SeeedDocument/Grove_Base_HAT/img/Grove Base HAT.JPG

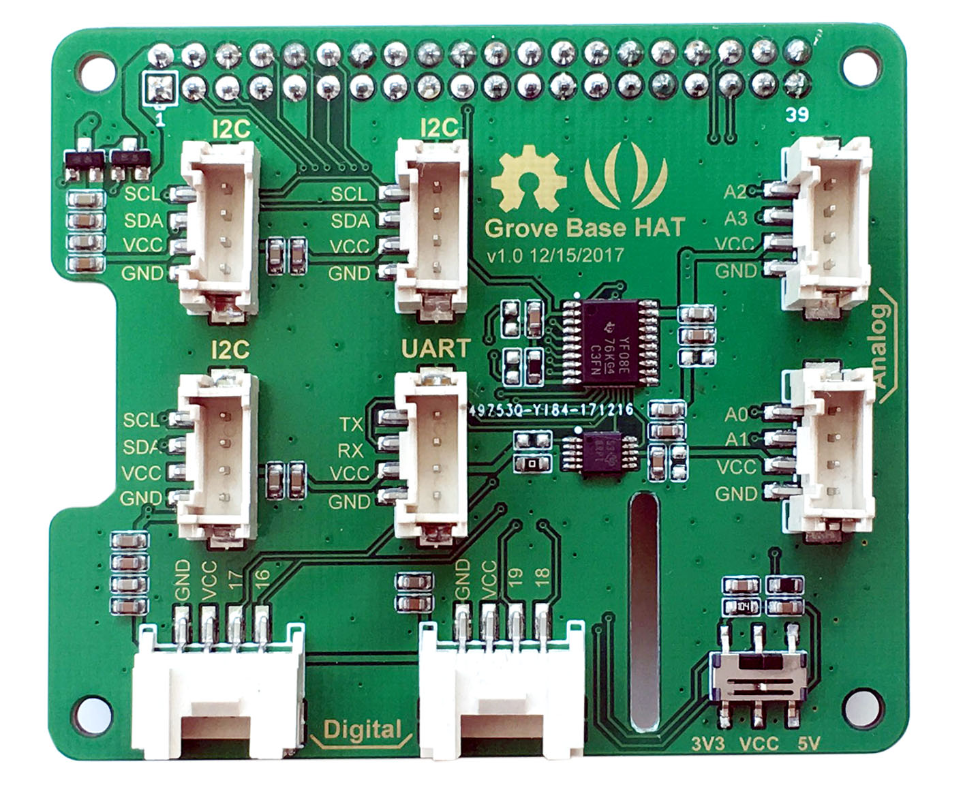
img/Grove Base HAT.JPG
