SeeedDocument/Grove_Base_HAT/img/enable_i2C.2.png

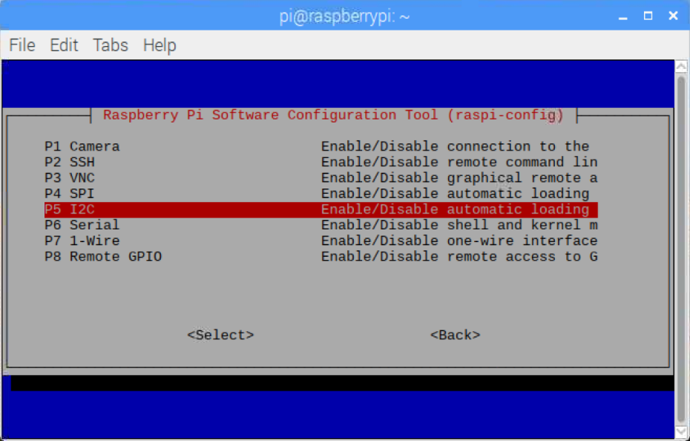
img/enable_i2C.2.png
