SeeedDocument/Grove_Base_HAT/img/enable_i2C.3.png

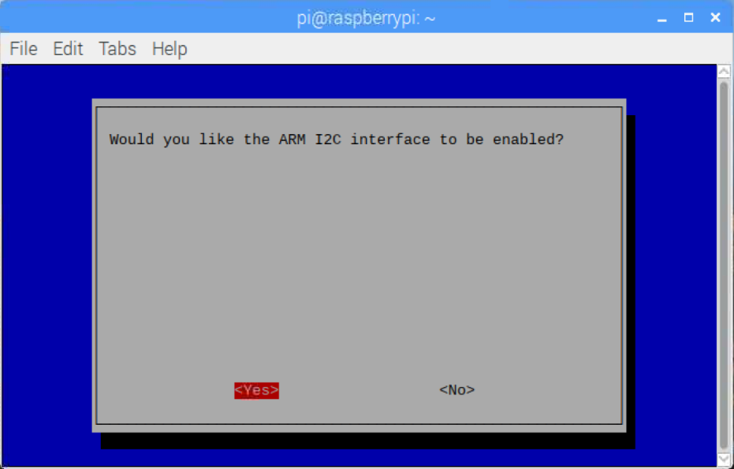
img/enable_i2C.3.png
