SeeedDocument/Grove_Base_HAT/img/Grove Base HAT_s.JPG

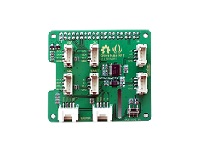
img/Grove Base HAT_s.JPG
