SeeedDocument/Grove_Base_HAT/res/Raspberry Pi Grove Base HAT BRD.pdf

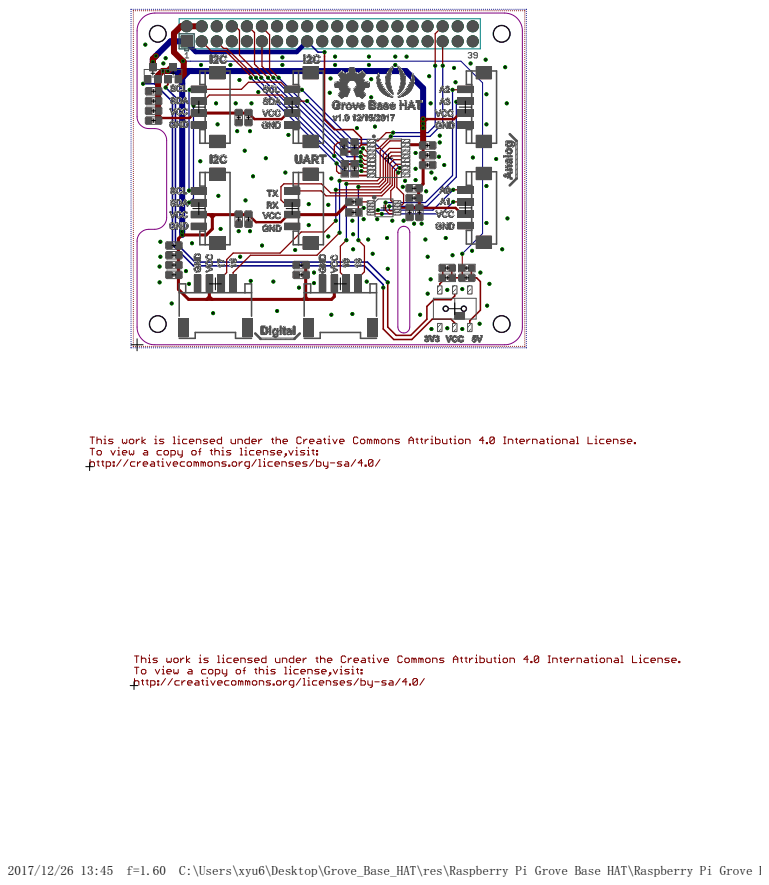
[picture p8: page 1]

2017/12/26 13:45 f=1.60 C:\Users\xyu6\Desktop\Grove_Base_HAT\res\Raspberry Pi Grove Base HAT\Raspberry Pi Grove Base HAT.brd
