SeeedDocument/Grove_Base_HAT/res/Raspberry Pi Grove Base HAT SCH.pdf

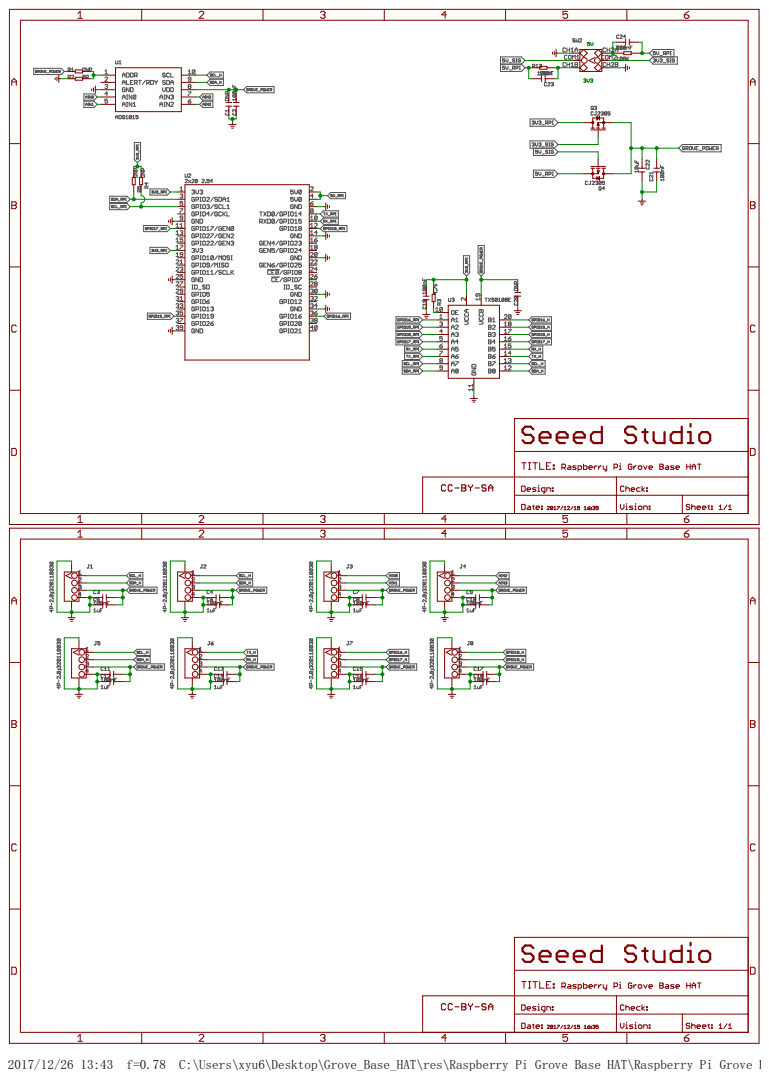
[picture p9: page 1]

2017/12/26 13:43 f=0.78 C:\Users\xyu6\Desktop\Grove_Base_HAT\res\Raspberry Pi Grove Base HAT\Raspberry Pi Grove Base HAT.sch (Sheet: 1/1)
