SeeedDocument/Grove_Base_HAT/res/Raspberry Pi Grove Base HAT/Raspberry Pi Grove Base HAT.brd

## EAGLE design res/Raspberry Pi Grove Base HAT/Raspberry Pi Grove Base HAT.brd (2017-12-26, last stored version)

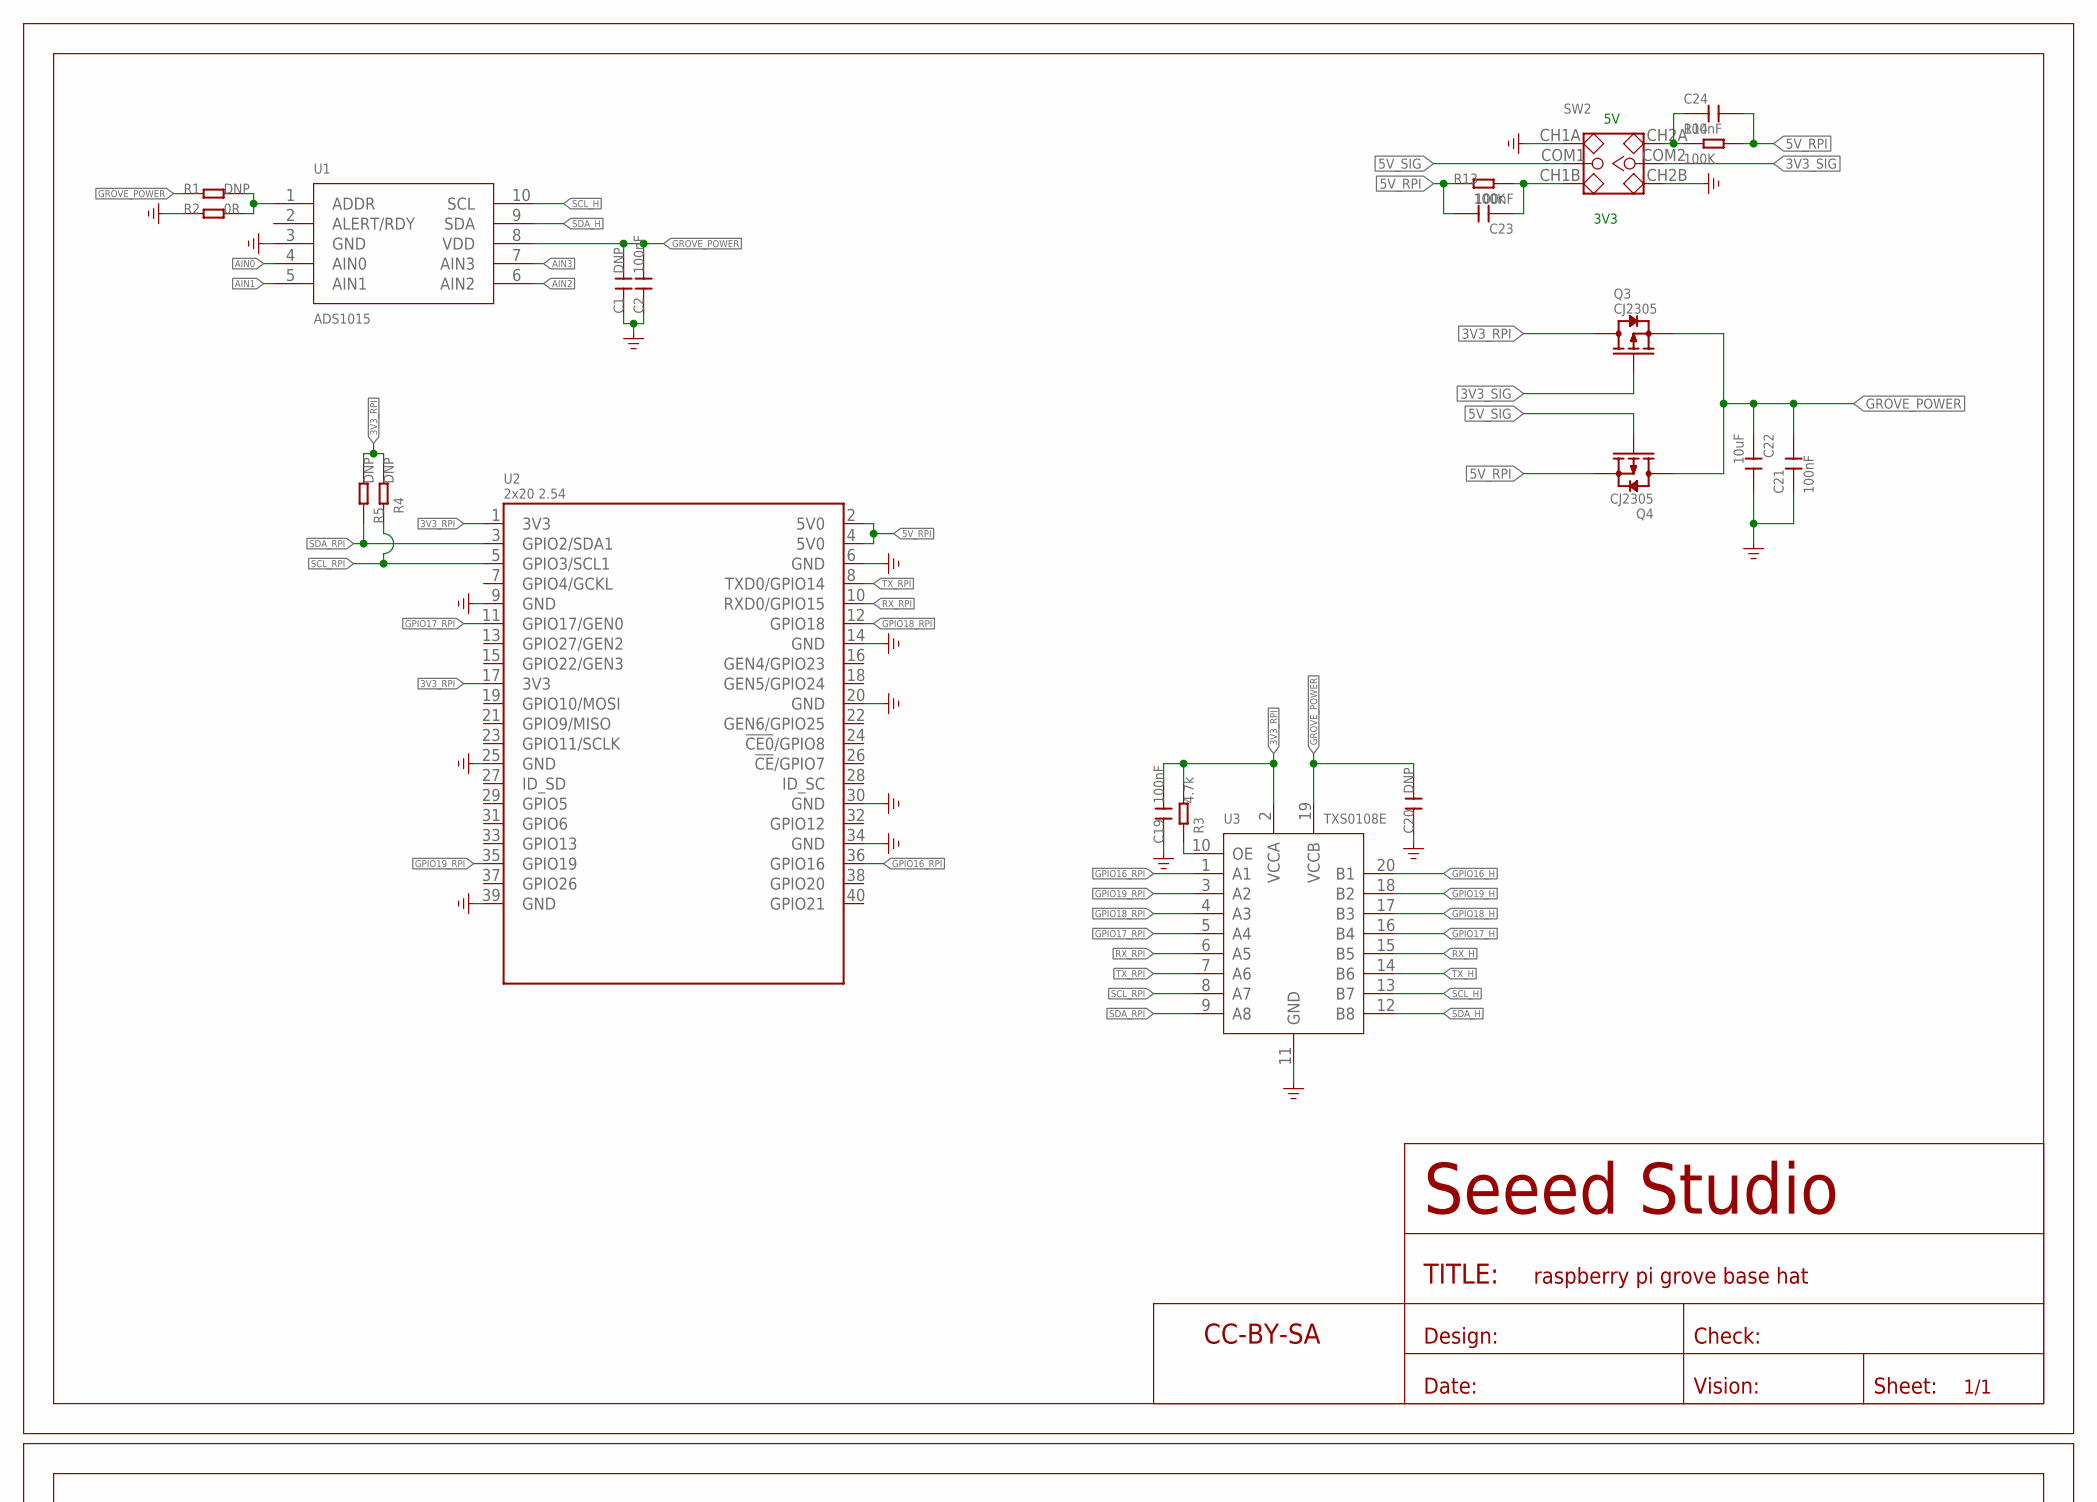
[picture p10: schematic Raspberry Pi Grove Base HAT.sch, part in row 1, column 1]

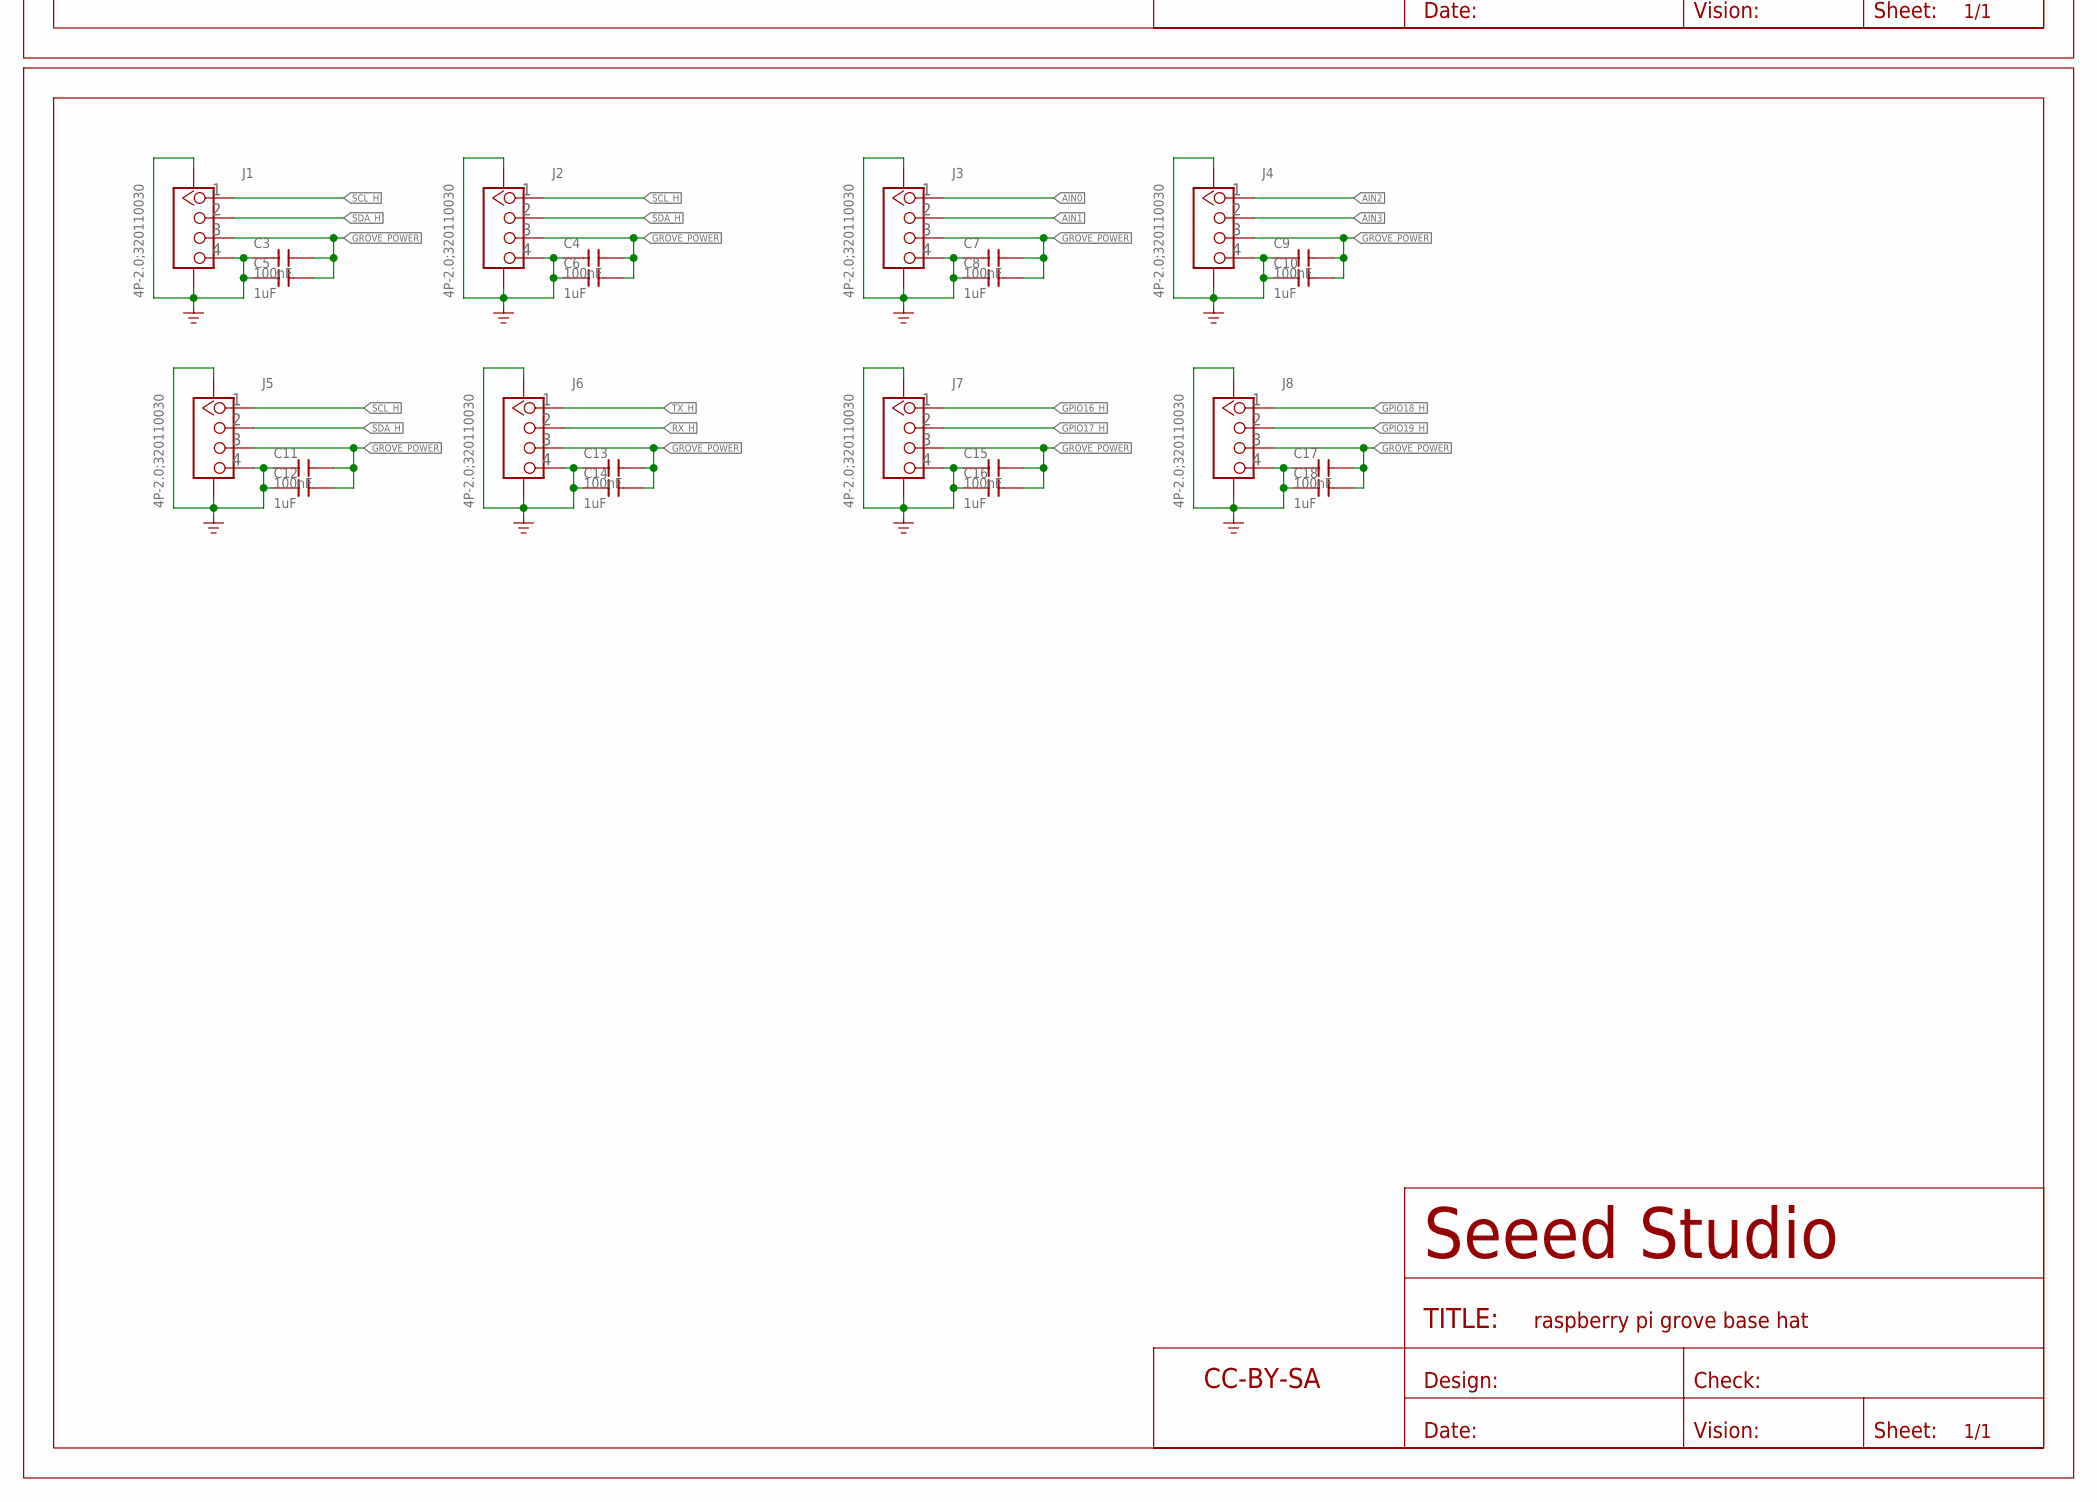
[picture p11: schematic Raspberry Pi Grove Base HAT.sch, part in row 2, column 1]

Parts:
C1, C20: DNP; C0603
C2, C3, C4, C7, C9, C11, C13, C15, C17, C19, C21, C23, C24: 100nF; C0603
C5, C6, C8, C10, C12, C14, C16, C18: 1uF; C0603
C22: 10uF; C0603
FR, FR1: SEEEDSTUDIO-OPEN-SCH-FRAME; SEEEDSTUDIO-PCB-FRAME
J1, J2, J3, J4, J5, J6: 4P-2.0;320110030; HW4-SMD-2.0
J7, J8: 4P-2.0;320110030; HW4-SMD-2.0-90D
Q3, Q4: CJ2305; SOT-23
R1, R4, R5: DNP; R0603
R2: 0R; R0603
R3: 4.7k; R0603
R13, R14: 100K; R0603
SW2: SWITCH-2CH-6P-2.54; 6P-SMD-2CH-2.54-3.5X7.2
U1: ADS1015; SSOP10-0.5-3X3MM
U2: 2x20 2.54; RASPI_BOARD_B+HAT_DF_CF
U3: TXS0108E; TSSOP20-0.65-6.5X4.4MM

Connections:
3V3_RPI: C19.2, Q3.3 (D), R3.2, R4.2, R5.2, U2.1 (3V3), U2.17 (3V3), U3.2 (VCCA)
3V3_SIG: Q3.1 (G), SW2.COM2
5V_RPI: C23.2, C24.2, Q4.2 (S), R13.1, R14.2, U2.2 (5V0), U2.4 (5V0)
5V_SIG: Q4.1 (G), SW2.COM1
AIN0: J3.1, U1.4 (AIN0)
AIN1: J3.2, U1.5 (AIN1)
AIN2: J4.1, U1.6 (AIN2)
AIN3: J4.2, U1.7 (AIN3)
GND: C1.1, C2.1, C3.1, C4.1, C5.1, C6.1, C7.1, C8.1, C9.1, C10.1, C11.1, C12.1, C13.1, C14.1, C15.1, C16.1, C17.1, C18.1, C19.1, C20.1, C21.1, C22.2, J1.4, J1.SS1, J1.SS2, J2.4, J2.SS1, J2.SS2, J3.4, J3.SS1, J3.SS2, J4.4, J4.SS1, J4.SS2, J5.4, J5.SS1, J5.SS2, J6.4, J6.SS1, J6.SS2, J7.4, J7.SS1, J7.SS2, J8.4, J8.SS1, J8.SS2, R2.1, SW2.CH1A, SW2.CH2B, U1.3 (GND), U2.6 (GND), U2.9 (GND), U2.14 (GND), U2.20 (GND), U2.25 (GND), U2.30 (GND), U2.34 (GND), U2.39 (GND), U3.11 (GND)
GPIO16_H: J7.1, U3.20 (B1)
GPIO16_RPI: U2.36 (GPIO16), U3.1 (A1)
GPIO17_H: J7.2, U3.16 (B4)
GPIO17_RPI: U2.11 (GPIO17/GEN0), U3.5 (A4)
GPIO18_H: J8.1, U3.17 (B3)
GPIO18_RPI: U2.12 (GPIO18), U3.4 (A3)
GPIO19_H: J8.2, U3.18 (B2)
GPIO19_RPI: U2.35 (GPIO19), U3.3 (A2)
GROVE_POWER: C1.2, C2.2, C3.2, C4.2, C5.2, C6.2, C7.2, C8.2, C9.2, C10.2, C11.2, C12.2, C13.2, C14.2, C15.2, C16.2, C17.2, C18.2, C20.2, C21.2, C22.1, J1.3, J2.3, J3.3, J4.3, J5.3, J6.3, J7.3, J8.3, Q3.2 (S), Q4.3 (D), R1.1, U1.8 (VDD), U3.19 (VCCB)
unnamed: R1.2, R2.2, U1.1 (ADDR)
unnamed: R3.1, U3.10 (OE)
unnamed: C23.1, R13.2, SW2.CH1B
unnamed: C24.1, R14.1, SW2.CH2A
RX_H: J6.2, U3.15 (B5)
RX_RPI: U2.10 (RXD0/GPIO15), U3.6 (A5)
SCL_H: J1.1, J2.1, J5.1, U1.10 (SCL), U3.13 (B7)
SCL_RPI: R4.1, U2.5 (GPIO3/SCL1), U3.8 (A7)
SDA_H: J1.2, J2.2, J5.2, U1.9 (SDA), U3.12 (B8)
SDA_RPI: R5.1, U2.3 (GPIO2/SDA1), U3.9 (A8)
TX_H: J6.1, U3.14 (B6)
TX_RPI: U2.8 (TXD0/GPIO14), U3.7 (A6)

Notes on the sheet:
3V3

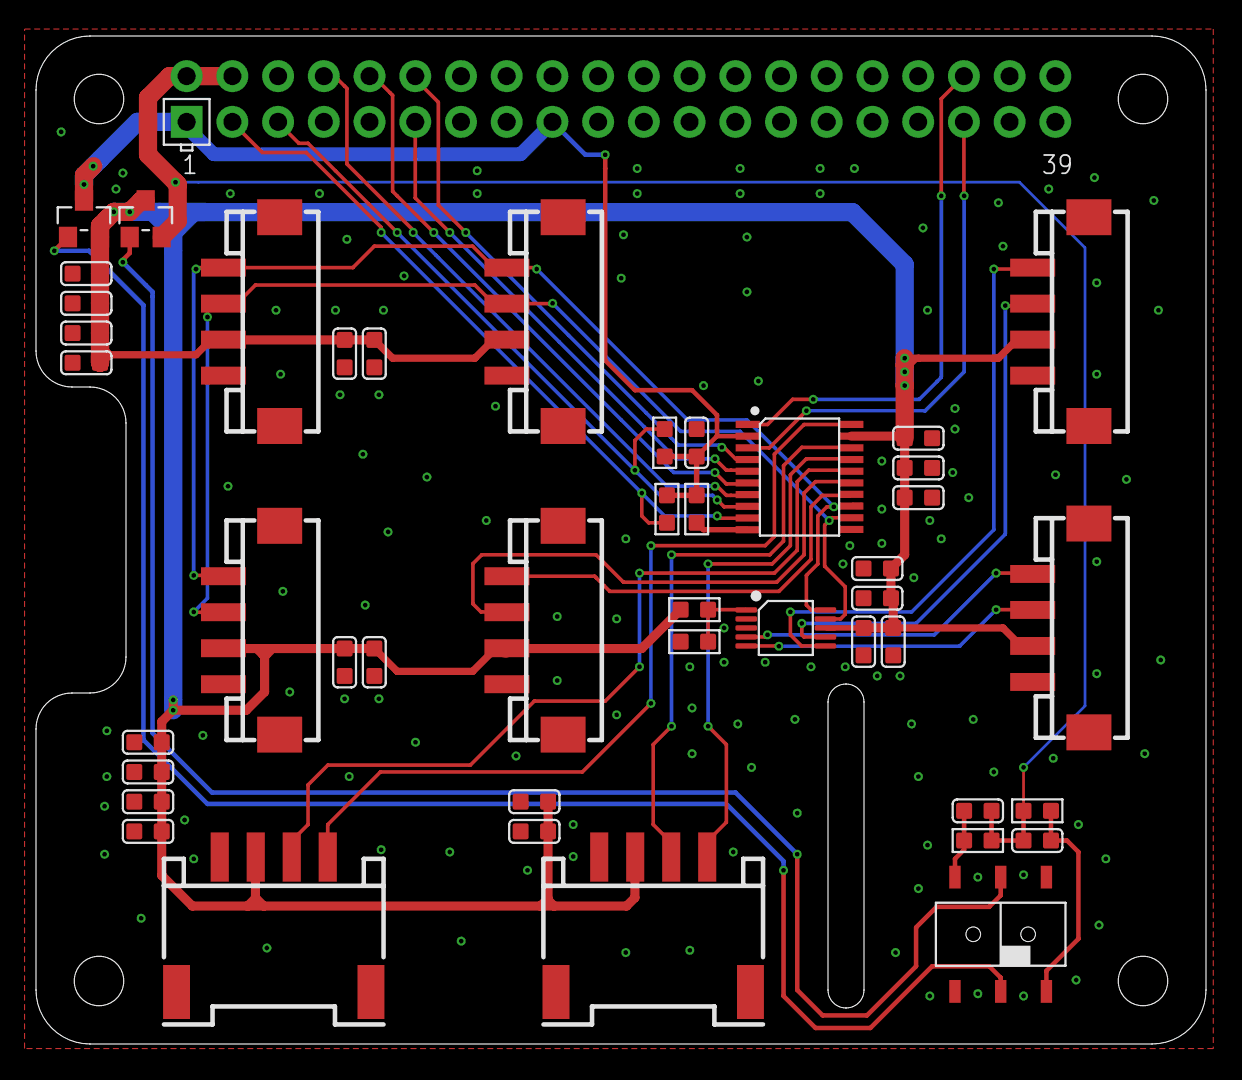
[picture p12: board Raspberry Pi Grove Base HAT.brd from above]

Board: 2 copper layers, 65.0 x 56.0 mm, 47 parts (0 on the bottom side), 30 nets.
